earweare/Seed3-Desktop-Dev-Kit/boitier/v2/Comparaison_photo_KiCad.png

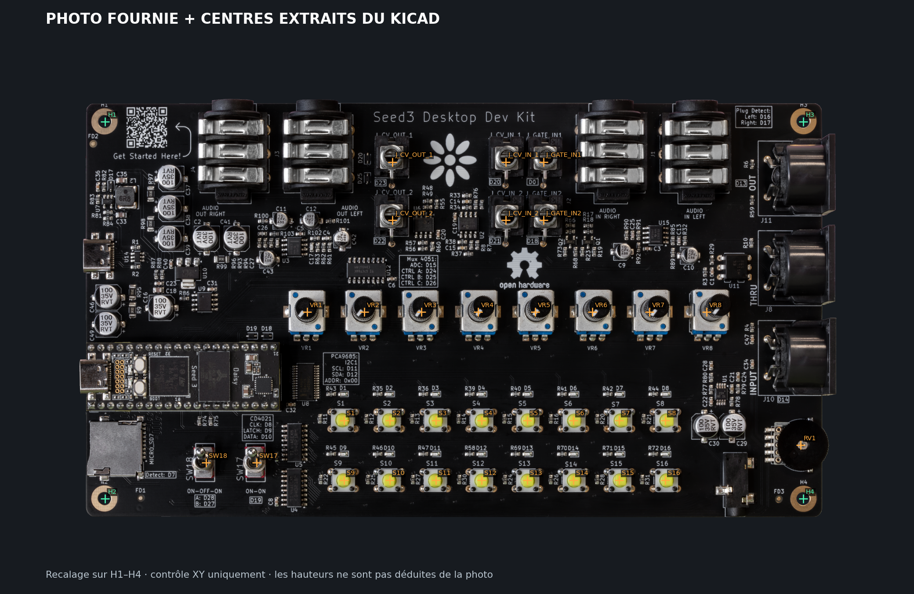
boitier/v2/Comparaison_photo_KiCad.png
