earweare/Seed3-Desktop-Dev-Kit/boitier/v2/Comparaison_photo_oblique.png

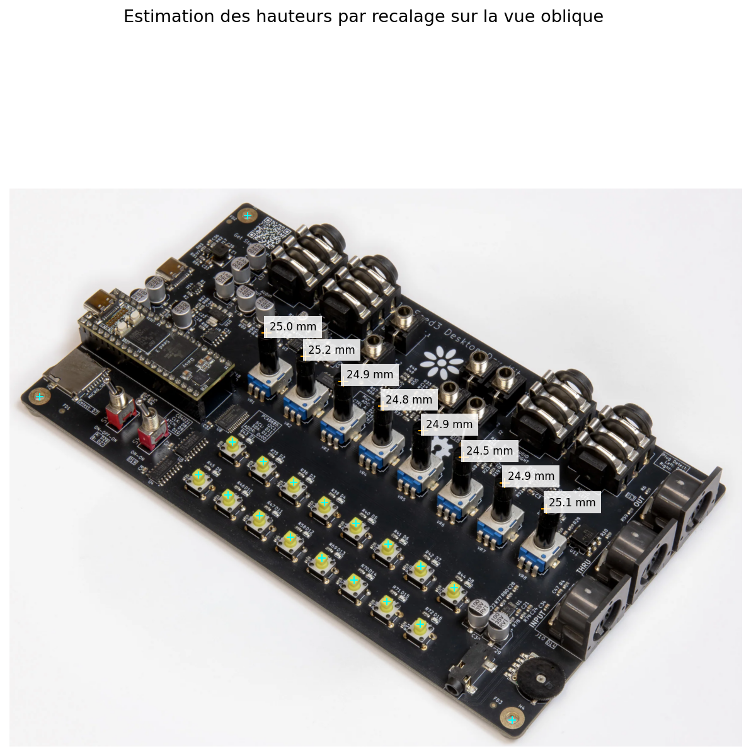
boitier/v2/Comparaison_photo_oblique.png
