earweare/Seed3-Desktop-Dev-Kit/boitier/v2/Vue_3D_board.png

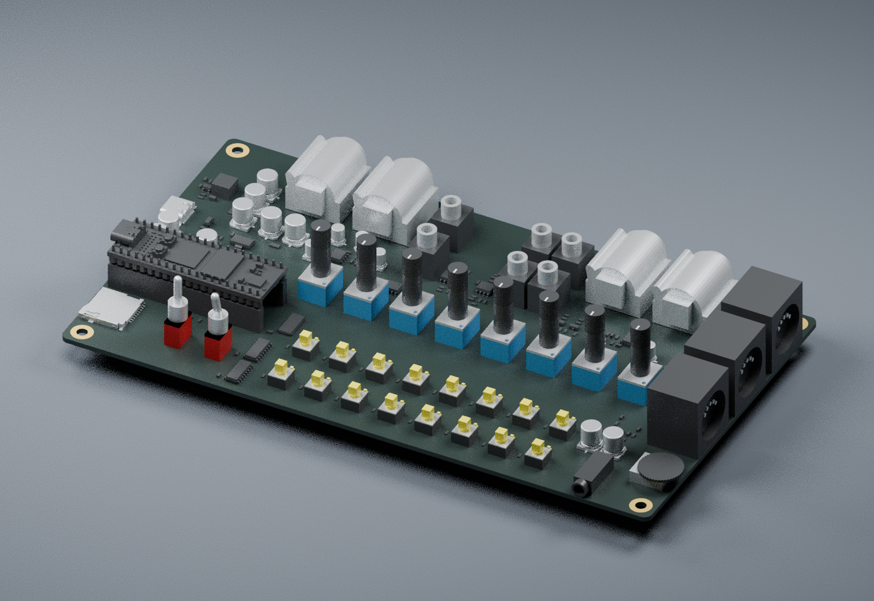
boitier/v2/Vue_3D_board.png
