earweare/Seed3-Desktop-Dev-Kit/boitier/v2/Vue_3D_exploded.png

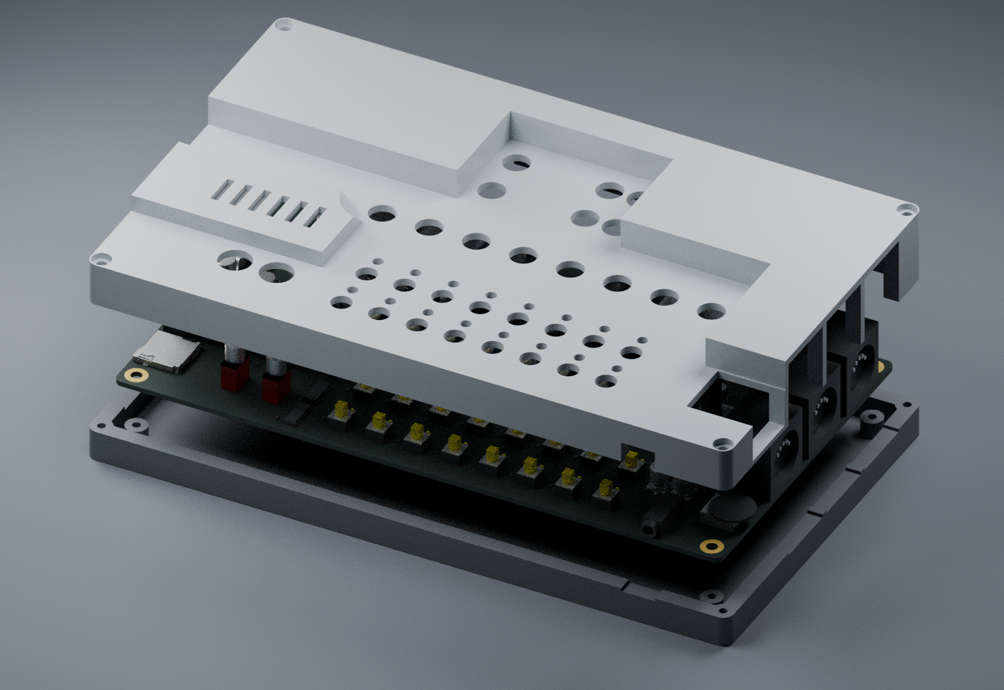
boitier/v2/Vue_3D_exploded.png
