earweare/Seed3-Desktop-Dev-Kit/boitier/v2/Vue_carte_dessus.png

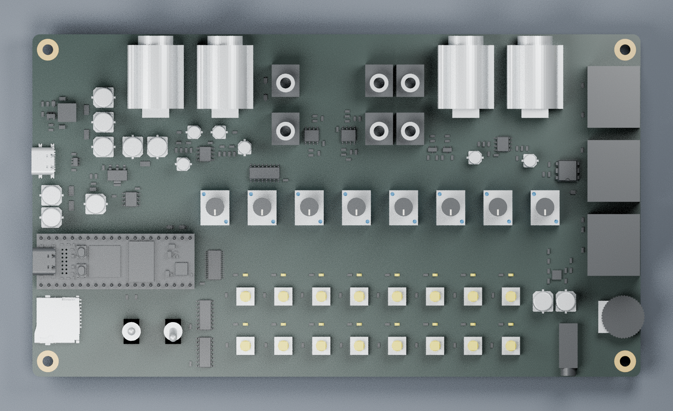
boitier/v2/Vue_carte_dessus.png
