earweare/Seed3-Desktop-Dev-Kit/boitier/v2/Sources/seed3-hardware/pcb/Seed3-DevKit-Desktop/production/ES-Seed3-Devkit-Desktop-Rev4_bom.csv

Value | Reference | Footprint | Qty | AVL_Part_Number
 | J_CV_IN_1,J_CV_IN_2,J_CV_OUT_1,J_CV_OUT_2,J_GATE_IN1,J_GATE_IN2 | Electrosmith-Interface:S_JACK | 6
0R | R84 | Resistor_SMD:R_0603_1608Metric | 1 | 0R R0603
1NF | C14,C15 | Capacitor_SMD:C_0603_1608Metric | 2 | 1NF C0603
1UF | C21 | Capacitor_SMD:C_0603_1608Metric | 1 | 1UF C0603
3R3 | R9,R95,R97,R98,R99 | Resistor_SMD:R_1206_3216Metric | 5 | 3R3
10UF MLCC | C18,C33,C35 | Capacitor_SMD:C_0805_2012Metric | 3 | 10UF MLCC C0805
10R | R6,R10,R29,R59 | Resistor_SMD:R_0603_1608Metric | 4 | 10R R0603
10UF | C9,C10,C11,C12,C42,C43 | Capacitor_SMD:CP_Elec_4x5.8 | 6 | 10UF
100NF | C1,C3,C5,C6,C7,C8,C19,C20,C22,C23,C31,C32,C34,C40,C47 | Capacitor_SMD:C_0603_1608Metric | 15 | 100NF C0603
100R | R23,R55,R60,R73,R102,R103 | Resistor_SMD:R_0603_1608Metric | 6 | 100R R0603
100UF | C2,C16,C29,C30,C37,C38,C39,C41,C46,C49 | Capacitor_SMD:CP_Elec_6.3x7.7 | 10 | 100UF
220R | R4 | Resistor_SMD:R_0603_1608Metric | 1 | 220R R0603
270R | R3 | Resistor_SMD:R_0603_1608Metric | 1 | 270R R0603
470NF | C24,C28 | Capacitor_SMD:C_0603_1608Metric | 2 | 470NF C0603
750R | R62,R93 | Resistor_SMD:R_0603_1608Metric | 2 | 750R R0603
1K | R89,R92 | Resistor_SMD:R_0603_1608Metric | 2 | 1K R0603
2K | R35,R36,R39,R40,R41,R42,R43,R44,R45,R46,R47,R58,R69,R70,R71,R72,R74,R75 | Resistor_SMD:R_0603_1608Metric | 18 | 2K R0603
5K1 | R1,R2 | Resistor_SMD:R_0603_1608Metric | 2 | 5K1 R0603
10K | R11,R12,R13,R14,R15,R16,R19,R20,R21,R22,R24,R25,R26,R27,R28,R30,R31,R61,R68,R83,R85,R86,R87,R88,R91,R96,R100,R101 | Resistor_SMD:R_0603_1608Metric | 28 | 10K R0603
20K | R32,R63,R90,R94 | Resistor_SMD:R_0603_1608Metric | 4 | 20K R0603
22K | R79,R80 | Resistor_SMD:R_0603_1608Metric | 2 | 22K R0603
33K | R5,R7,R34,R38,R77,R78 | Resistor_SMD:R_0603_1608Metric | 6 | 33K R0603
47K | R50,R51,R52,R53,R54 | Resistor_SMD:R_0603_1608Metric | 5 | 47K R0603
62K | R49,R57,R82 | Resistor_SMD:R_0603_1608Metric | 3 | 62K R0603
100K | R8,R17,R33,R37,R66,R76 | Resistor_SMD:R_0603_1608Metric | 6 | 100K R0603
120K | R48,R56 | Resistor_SMD:R_0603_1608Metric | 2 | 120K R0603
1M | R18,R67,R81 | Resistor_SMD:R_0603_1608Metric | 3 | 1M R0603
470PF | C4,C26 | Capacitor_SMD:C_0603_1608Metric | 2 | 470PF C0603
560PF | C36 | Capacitor_SMD:C_0603_1608Metric | 1 | 560PF C0603
1N5817WS | D17,D18,D19,D20,D21,D25 | Diode_SMD:D_SOD-323F | 6 | 1N5817WS
330PF C0G | C13,C25 | Capacitor_SMD:C_0603_1608Metric | 2 | 330PF C0G C0603
470PF C0G | C17,C27 | Capacitor_SMD:C_0603_1608Metric | 2 | 470PF C0G C0603
6.8uH 2.9A | L2 | Inductor_SMD:L_TDK_VLS6045EX_VLS6045AF | 1 | 6.8uH 2.9A
AudioJack3_Switch | J1,J2,J3,J4 | Connector_Audio:Jack_6.35mm_Neutrik_NMJ6HCD2_Horizontal | 4 | AudioJack3_Switch
AudioJack3_Switch_HEADPHONE | J5 | Connector_Audio:Jack_3.5mm_CUI_SJ-3523-SMT_Horizontal | 1 | AudioJack3_Switch_HEADPHONE
CD4051B | U12 | Package_SO:SOIC-16_3.9x9.9mm_P1.27mm | 1 | CD4051B
CD4021BM96 | U4,U5 | Package_SO:SOIC-16_3.9x9.9mm_P1.27mm | 2 | CD4021BM96
DIN_MIDI_5P | J8,J10,J11 | parts-for-kicad:57PC5F | 3 | DIN_MIDI_5P
Electrosmith_Daisy_Seed_Rev4 | A1 | Module:Electrosmith_Daisy_Seed | 1 | Electrosmith_Daisy_Seed_Rev4
H11L1 | U11 | Package_DIP:DIP-6_W7.62mm | 1 | H11L1
LD1117S50TR_SOT223 | U10 | Package_TO_SOT_SMD:SOT-223-3_TabPin2 | 1 | LD1117S50TR_SOT223
LED | D1,D2,D3,D4,D5,D6,D7,D8,D9,D10,D11,D12,D13,D14,D15,D16 | LED_SMD:LED_0603_1608Metric | 16 | LED
LMR62421XMF | U7 | Package_TO_SOT_SMD:SOT-23-5 | 1 | LMR62421XMF
MCP6002-xSN | U2,U6,U9 | Package_SO:SOIC-8_3.9x4.9mm_P1.27mm | 3 | MCP6002-xSN
MMBT3904 | Q1,Q2 | Package_TO_SOT_SMD:SOT-23 | 2 | MMBT3904
OPA1652 | U3,U15 | Package_SO:SOIC-8_3.9x4.9mm_P1.27mm | 2 | OPA1652
P-10K-B-R | VR1,VR2,VR3,VR4,VR5,VR6,VR7,VR8 | parts-for-kicad:9MM_SNAP-IN_POT_SILK | 8 | P-10K-B-R
PCA9685PW | U8 | Package_SO:TSSOP-28_4.4x9.7mm_P0.65mm | 1 | PCA9685PW
PTH Mini Button | S1,S2,S3,S4,S5,S6,S7,S8,S9,S10,S11,S12,S13,S14,S15,S16 | parts-for-kicad:TL1105SPF250Q_SILK | 16 | PTH Mini Button
R_Potentiometer_Dual_Separate | RV1 | shnsly:Rotary Pot RK10J | 1 | R_Potentiometer_Dual_Separate
TF-01A | MICRO_SD7 | TF-01A:TF-01A | 1 | TF-01A
TOGGLE_ON-ON_PIP3 | SW17 | Electrosmith-Interface:TOGGLE_ON-ON | 1 | TOGGLE_ON-ON_PIP3
TOGGLE_ON_OFF_ON_PIP2 | SW18 | Electrosmith-Interface:TOGGLE_ON_OFF_ON | 1 | TOGGLE_ON_OFF_ON_PIP2
TPA6110A2DGN | U1 | Package_SO:HVSSOP-8-1EP_3x3mm_P0.65mm_EP1.57x1.89mm | 1 | TPA6110A2DGN
USB4110GFA | J7 | USB4110GFA:GCT_USB4110GFA | 1 | USB4110GFA
USBLC6-2SC6 | U14 | Package_TO_SOT_SMD:SOT-23-6 | 1 | USBLC6-2SC6
