earweare/Seed3-Desktop-Dev-Kit/boitier/v2/Implantation_KiCad_mm.csv

reference | x_from_left_mm | y_from_front_mm | rotation_deg | footprint
A1 | 2.7950000000000017 | 29.705 | 90.0 | Module:Electrosmith_Daisy_Seed
C1 | 167.4 | 65.6 | -90.0 | Capacitor_SMD:C_0603_1608Metric
C10 | 161.2 | 70.0 | 180.0 | Capacitor_SMD:CP_Elec_4x5.8
C11 | 52.400000000000006 | 79.25 | 180.0 | Capacitor_SMD:CP_Elec_4x5.8
C12 | 60.5 | 79.25 | 0 | Capacitor_SMD:CP_Elec_4x5.8
C13 | 158.6 | 74.0 | 90.0 | Capacitor_SMD:C_0603_1608Metric
C14 | 102.0 | 84.4 | 0 | Capacitor_SMD:C_0603_1608Metric
C15 | 100.80000000000001 | 72.0 | 0 | Capacitor_SMD:C_0603_1608Metric
C16 | 20.5 | 56.0 | 180.0 | Capacitor_SMD:CP_Elec_6.3x7.7
C17 | 60.599999999999994 | 72.2 | -90.0 | Capacitor_SMD:C_0603_1608Metric
C18 | 19.599999999999994 | 60.775000000000006 | 180.0 | Capacitor_SMD:C_0805_2012Metric
C19 | 98.80000000000001 | 80.2 | -90.0 | Capacitor_SMD:C_0603_1608Metric
C2 | 32.5 | 74.5 | 90.0 | Capacitor_SMD:CP_Elec_6.3x7.7
C20 | 94.33000000000001 | 75.6 | -90.0 | Capacitor_SMD:C_0603_1608Metric
C21 | 172.74 | 34.400000000000006 | -90.0 | Capacitor_SMD:C_0603_1608Metric
C22 | 167.2 | 31.0 | 90.0 | Capacitor_SMD:C_0603_1608Metric
C23 | 19.775000000000006 | 62.575 | 180.0 | Capacitor_SMD:C_0603_1608Metric
C24 | 174.4 | 37.599999999999994 | 90.0 | Capacitor_SMD:C_0603_1608Metric
C25 | 146.2 | 75.4 | 90.0 | Capacitor_SMD:C_0603_1608Metric
C26 | 47.400000000000006 | 75.8 | 0 | Capacitor_SMD:C_0603_1608Metric
C27 | 51.400000000000006 | 73.4 | -90.0 | Capacitor_SMD:C_0603_1608Metric
C28 | 167.2 | 40.599999999999994 | 90.0 | Capacitor_SMD:C_0603_1608Metric
C29 | 172.8 | 24.400000000000006 | -90.0 | Capacitor_SMD:CP_Elec_6.3x7.7
C3 | 150.2 | 71.8 | 180.0 | Capacitor_SMD:C_0603_1608Metric
C30 | 165.4 | 24.400000000000006 | -90.0 | Capacitor_SMD:CP_Elec_6.3x7.7
C31 | 34.0 | 61.004999999999995 | 180.0 | Capacitor_SMD:C_0603_1608Metric
C32 | 55.025000000000006 | 30.200000000000003 | 0 | Capacitor_SMD:C_0603_1608Metric
C33 | 9.600000000000001 | 80.9 | 0 | Capacitor_SMD:C_0805_2012Metric
C34 | 178.2 | 41.0 | -90.0 | Capacitor_SMD:C_0603_1608Metric
C35 | 9.700000000000003 | 90.1 | 0 | Capacitor_SMD:C_0805_2012Metric
C36 | 3.299999999999997 | 88.4 | 90.0 | Capacitor_SMD:C_0603_1608Metric
C37 | 23.0 | 90.5 | 0 | Capacitor_SMD:CP_Elec_6.3x7.7
C38 | 23.0 | 82.5 | 0 | Capacitor_SMD:CP_Elec_6.3x7.7
C39 | 23.0 | 74.5 | 0 | Capacitor_SMD:CP_Elec_6.3x7.7
C4 | 64.6 | 74.6 | 180.0 | Capacitor_SMD:C_0603_1608Metric
C40 | 23.0 | 67.75 | -90.0 | Capacitor_SMD:C_0603_1608Metric
C41 | 40.5 | 74.5 | 90.0 | Capacitor_SMD:CP_Elec_6.3x7.7
C42 | 68.75 | 74.25 | -90.0 | Capacitor_SMD:CP_Elec_4x5.8
C43 | 48.900000000000006 | 68.9 | 180.0 | Capacitor_SMD:CP_Elec_4x5.8
C46 | 6.200000000000003 | 58.8 | 180.0 | Capacitor_SMD:CP_Elec_6.3x7.7
C47 | 178.2 | 47.599999999999994 | 90.0 | Capacitor_SMD:C_0603_1608Metric
C49 | 6.200000000000003 | 51.599999999999994 | 180.0 | Capacitor_SMD:CP_Elec_6.3x7.7
C5 | 57.599999999999994 | 75.8 | 0 | Capacitor_SMD:C_0603_1608Metric
C6 | 82.02625 | 63.712500000000006 | 0 | Capacitor_SMD:C_0603_1608Metric
C7 | 51.2 | 16.224999999999994 | 90.0 | Capacitor_SMD:C_0603_1608Metric
C8 | 51.2 | 4.199999999999989 | 90.0 | Capacitor_SMD:C_0603_1608Metric
C9 | 143.4 | 71.0 | 180.0 | Capacitor_SMD:CP_Elec_4x5.8
D1 | 69.0 | 33.0 | 180.0 | LED_SMD:LED_0603_1608Metric
D10 | 81.28571400000001 | 17.0 | 180.0 | LED_SMD:LED_0603_1608Metric
D11 | 93.571429 | 17.0 | 180.0 | LED_SMD:LED_0603_1608Metric
D12 | 105.85714300000001 | 17.0 | 180.0 | LED_SMD:LED_0603_1608Metric
D13 | 118.14285699999999 | 17.0 | 180.0 | LED_SMD:LED_0603_1608Metric
D14 | 130.428571 | 17.0 | 180.0 | LED_SMD:LED_0603_1608Metric
D15 | 142.714286 | 17.0 | 180.0 | LED_SMD:LED_0603_1608Metric
D16 | 155.0 | 17.0 | 180.0 | LED_SMD:LED_0603_1608Metric
D17 | 6.799999999999997 | 88.5 | -90.0 | Diode_SMD:D_SOD-323F
D18 | 48.5 | 48.5 | 180.0 | Diode_SMD:D_SOD-323F
D19 | 44.5 | 48.5 | 180.0 | Diode_SMD:D_SOD-323F
D2 | 81.28571400000001 | 33.0 | 180.0 | LED_SMD:LED_0603_1608Metric
D20 | 75.5 | 96.0 | 90.0 | Diode_SMD:D_SOD-323F
D21 | 175.13 | 59.775000000000006 | 180.0 | Diode_SMD:D_SOD-323F
D25 | 75.5 | 90.5 | -90.0 | Diode_SMD:D_SOD-323F
D3 | 93.571429 | 33.0 | 180.0 | LED_SMD:LED_0603_1608Metric
D4 | 105.85714300000001 | 33.0 | 180.0 | LED_SMD:LED_0603_1608Metric
D5 | 118.14285699999999 | 33.0 | 180.0 | LED_SMD:LED_0603_1608Metric
D6 | 130.428571 | 33.0 | 180.0 | LED_SMD:LED_0603_1608Metric
D7 | 142.714286 | 33.0 | 180.0 | LED_SMD:LED_0603_1608Metric
D8 | 155.0 | 33.0 | 180.0 | LED_SMD:LED_0603_1608Metric
D9 | 69.0 | 17.0 | 180.0 | LED_SMD:LED_0603_1608Metric
FD1 | 14.769999999999996 | 5.139999999999986 | 0 | Fiducial:Fiducial_1mm_Mask2mm
FD2 | 2.001100000000001 | 99.9964 | 0 | Fiducial:Fiducial_1mm_Mask2mm
FD3 | 185.4 | 5.0 | 0 | Fiducial:Fiducial_1mm_Mask2mm
H1 | 5.0 | 106.0 | 0 | MountingHole:MountingHole_3.5mm_Pad
H2 | 5.0 | 5.0 | 0 | MountingHole:MountingHole_3.5mm_Pad
H3 | 192.0 | 106.0 | 0 | MountingHole:MountingHole_3.5mm_Pad
H4 | 192.0 | 5.0 | 0 | MountingHole:MountingHole_3.5mm_Pad
J1 | 154.685 | 90.765 | 90.0 | Connector_Audio:Jack_6.35mm_Neutrik_NMJ6HCD2_Horizontal
J10 | 184.8 | 42.7 | 90.0 | PartsFromEagle:57PC5F
J11 | 184.8 | 90.7 | 90.0 | PartsFromEagle:57PC5F
J2 | 132.285 | 90.765 | 90.0 | Connector_Audio:Jack_6.35mm_Neutrik_NMJ6HCD2_Horizontal
J3 | 54.285 | 90.765 | 90.0 | Connector_Audio:Jack_6.35mm_Neutrik_NMJ6HCD2_Horizontal
J4 | 31.799999999999997 | 90.8 | 90.0 | Connector_Audio:Jack_6.35mm_Neutrik_NMJ6HCD2_Horizontal
J5 | 173.6 | 8.800000000000011 | 180.0 | Connector_Audio:Jack_3.5mm_CUI_SJ-3523-SMT_Horizontal
J7 | 6.0 | 69.91 | -90.0 | USB4110GFA:GCT_USB4110GFA
J8 | 184.8 | 66.7 | 90.0 | PartsFromEagle:57PC5F
J_CV_IN_1 | 112.30000000000001 | 95.2 | 0 | PartsFromEagle:EURO_JACK_3.5MM
J_CV_IN_2 | 112.30000000000001 | 79.6 | 0 | PartsFromEagle:EURO_JACK_3.5MM
J_CV_OUT_1 | 82.0 | 95.2 | 0 | PartsFromEagle:EURO_JACK_3.5MM
J_CV_OUT_2 | 82.0 | 79.6 | 0 | PartsFromEagle:EURO_JACK_3.5MM
J_GATE_IN1 | 122.4 | 95.2 | 0 | PartsFromEagle:EURO_JACK_3.5MM
J_GATE_IN2 | 122.4 | 79.6 | 0 | PartsFromEagle:EURO_JACK_3.5MM
L2 | 11.200000000000003 | 85.6 | 90.0 | Inductor_SMD:L_TDK_VLS6045EX_VLS6045AF
LOGO1 | 117.35 | 66.5 | 0 | Symbol:OSHW-Logo2_14.6x12mm_SilkScreen
MICRO_SD7 | 8.274999999999999 | 18.30000000000001 | -90.0 | TF-01A:TF-01A
Q1 | 134.3875 | 73.54 | -90.0 | Package_TO_SOT_SMD:SOT-23
Q2 | 129.6 | 73.6 | -90.0 | Package_TO_SOT_SMD:SOT-23
QR1 | 16.400000000000006 | 104.3 | 0 | shnsly:qr-seed3-desktop-redirect-medium
R1 | 13.399999999999999 | 72.2 | 0 | Resistor_SMD:R_0603_1608Metric
R10 | 178.0 | 73.4 | 90.0 | Resistor_SMD:R_0603_1608Metric
R100 | 47.5 | 79.2 | 180.0 | Resistor_SMD:R_0603_1608Metric
R101 | 65.6 | 79.2 | 0 | Resistor_SMD:R_0603_1608Metric
R102 | 61.442499999999995 | 74.6 | 0 | Resistor_SMD:R_0603_1608Metric
R103 | 50.575 | 75.8 | 0 | Resistor_SMD:R_0603_1608Metric
R11 | 62.8 | 26.400000000000006 | -90.0 | Resistor_SMD:R_0603_1608Metric
R12 | 75.2 | 26.400000000000006 | -90.0 | Resistor_SMD:R_0603_1608Metric
R13 | 87.4 | 26.400000000000006 | -90.0 | Resistor_SMD:R_0603_1608Metric
R14 | 99.80000000000001 | 26.400000000000006 | -90.0 | Resistor_SMD:R_0603_1608Metric
R15 | 112.0 | 26.400000000000006 | -90.0 | Resistor_SMD:R_0603_1608Metric
R16 | 124.4 | 26.400000000000006 | -90.0 | Resistor_SMD:R_0603_1608Metric
R17 | 134.3875 | 77.985 | 0 | Resistor_SMD:R_0603_1608Metric
R18 | 134.3875 | 76.3975 | 0 | Resistor_SMD:R_0603_1608Metric
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
R80 | 167.2 | 37.425 | -90.0 | Resistor_SMD:R_0603_1608Metric
R81 | 6.0 | 81.6 | 0 | Resistor_SMD:R_0603_1608Metric
R82 | 4.899999999999999 | 88.4 | -90.0 | Resistor_SMD:R_0603_1608Metric
R83 | 3.299999999999997 | 85.1 | -90.0 | Resistor_SMD:R_0603_1608Metric
R84 | 6.0 | 80.0 | 180.0 | Resistor_SMD:R_0603_1608Metric
R85 | 157.0 | 74.0 | -90.0 | Resistor_SMD:R_0603_1608Metric
R86 | 26.5 | 58.5 | 180.0 | Resistor_SMD:R_0603_1608Metric
R87 | 19.0 | 64.975 | -90.0 | Resistor_SMD:R_0603_1608Metric
R88 | 20.599999999999994 | 64.975 | 90.0 | Resistor_SMD:R_0603_1608Metric
R89 | 157.0 | 70.8 | -90.0 | Resistor_SMD:R_0603_1608Metric
R9 | 12.600000000000001 | 55.400000000000006 | -90.0 | Resistor_SMD:R_1206_3216Metric
R90 | 144.6 | 75.4 | -90.0 | Resistor_SMD:R_0603_1608Metric
R91 | 147.8 | 75.4 | -90.0 | Resistor_SMD:R_0603_1608Metric
R92 | 147.8 | 72.2 | -90.0 | Resistor_SMD:R_0603_1608Metric
R93 | 48.2 | 73.4 | 90.0 | Resistor_SMD:R_0603_1608Metric
R94 | 49.8 | 73.4 | -90.0 | Resistor_SMD:R_0603_1608Metric
R95 | 12.600000000000001 | 60.2 | -90.0 | Resistor_SMD:R_1206_3216Metric
R96 | 46.599999999999994 | 73.4 | -90.0 | Resistor_SMD:R_0603_1608Metric
R97 | 17.5 | 86.5 | -90.0 | Resistor_SMD:R_1206_3216Metric
R98 | 17.5 | 78.5 | -90.0 | Resistor_SMD:R_1206_3216Metric
R99 | 36.5 | 69.0 | 0 | Resistor_SMD:R_1206_3216Metric
RV1 | 191.325 | 19.400000000000006 | -90.0 | shnsly:Rotary Pot RK10J
S1 | 69.0 | 26.0 | 0 | PartsFromEagle:TL1105SPF250Q_SILK
S10 | 81.28571400000001 | 10.0 | 0 | PartsFromEagle:TL1105SPF250Q_SILK
S11 | 93.571429 | 10.0 | 0 | PartsFromEagle:TL1105SPF250Q_SILK
S12 | 105.85714300000001 | 10.0 | 0 | PartsFromEagle:TL1105SPF250Q_SILK
S13 | 118.14285699999999 | 10.0 | 0 | PartsFromEagle:TL1105SPF250Q_SILK
S14 | 130.428571 | 10.0 | 0 | PartsFromEagle:TL1105SPF250Q_SILK
S15 | 142.714286 | 10.0 | 0 | PartsFromEagle:TL1105SPF250Q_SILK
S16 | 155.0 | 10.0 | 0 | PartsFromEagle:TL1105SPF250Q_SILK
S2 | 81.28571400000001 | 26.0 | 0 | PartsFromEagle:TL1105SPF250Q_SILK
S3 | 93.571429 | 26.0 | 0 | PartsFromEagle:TL1105SPF250Q_SILK
S4 | 105.85714300000001 | 26.0 | 0 | PartsFromEagle:TL1105SPF250Q_SILK
S5 | 118.14285699999999 | 26.0 | 0 | PartsFromEagle:TL1105SPF250Q_SILK
S6 | 130.428571 | 26.0 | 0 | PartsFromEagle:TL1105SPF250Q_SILK
S7 | 142.714286 | 26.0 | 0 | PartsFromEagle:TL1105SPF250Q_SILK
S8 | 155.0 | 26.0 | 0 | PartsFromEagle:TL1105SPF250Q_SILK
S9 | 69.0 | 10.0 | 0 | PartsFromEagle:TL1105SPF250Q_SILK
SW17 | 45.567499999999995 | 14.664999999999992 | 90.0 | PartsFromEagle:TOGGLE_ON_ON_2
SW18 | 32.073750000000004 | 14.664999999999992 | 90.0 | PartsFromEagle:TOGGLE_ON_OFF_ON
U1 | 169.87 | 32.989999999999995 | -90.0 | Package_SO:HVSSOP-8-1EP_3x3mm_P0.65mm_EP1.57x1.89mm
U10 | 27.5 | 65.25 | -90.0 | Package_TO_SOT_SMD:SOT-223-3_TabPin2
U11 | 177.205 | 64.26 | 180.0 | Package_DIP:DIP-6_W7.62mm
U12 | 75.2 | 66.0 | -90.0 | Package_SO:SOIC-16_3.9x9.9mm_P1.27mm
U14 | 13.950099999999999 | 69.6 | 0 | Package_TO_SOT_SMD:SOT-23-6
U15 | 152.4 | 75.4 | 180.0 | Package_SO:SOIC-8_3.9x4.9mm_P1.27mm
U2 | 102.4 | 78.2 | 90.0 | Package_SO:SOIC-8_3.9x4.9mm_P1.27mm
U3 | 56.0 | 72.2 | 0 | Package_SO:SOIC-8_3.9x4.9mm_P1.27mm
U4 | 55.925 | 7.905000000000001 | 180.0 | Package_SO:SOIC-16_3.9x9.9mm_P1.27mm
U5 | 56.0 | 20.0 | 180.0 | Package_SO:SOIC-16_3.9x9.9mm_P1.27mm
U6 | 90.435 | 78.125 | -90.0 | Package_SO:SOIC-8_3.9x4.9mm_P1.27mm
U7 | 6.0 | 84.5 | -90.0 | Package_TO_SOT_SMD:SOT-23-5
U8 | 59.0 | 36.2 | 180.0 | Package_SO:TSSOP-28_4.4x9.7mm_P0.65mm
U9 | 31.974999999999994 | 57.5 | 0 | Package_SO:SOIC-8_3.9x4.9mm_P1.27mm
VR1 | 59.12350000000001 | 55.0 | 0 | PartsFromEagle:9MM_SNAP-IN_POT_SILK
VR2 | 74.4025 | 55.0 | 0 | PartsFromEagle:9MM_SNAP-IN_POT_SILK
VR3 | 89.6815 | 55.0 | 0 | PartsFromEagle:9MM_SNAP-IN_POT_SILK
VR4 | 104.9605 | 55.0 | 0 | PartsFromEagle:9MM_SNAP-IN_POT_SILK
VR5 | 120.23949999999999 | 55.0 | 0 | PartsFromEagle:9MM_SNAP-IN_POT_SILK
VR6 | 135.5185 | 55.0 | 0 | PartsFromEagle:9MM_SNAP-IN_POT_SILK
VR7 | 150.7975 | 55.0 | 0 | PartsFromEagle:9MM_SNAP-IN_POT_SILK
VR8 | 166.0765 | 55.0 | 0 | PartsFromEagle:9MM_SNAP-IN_POT_SILK
