earweare/Seed3-Desktop-Dev-Kit/boitier/v2/Boitier_Seed3.step

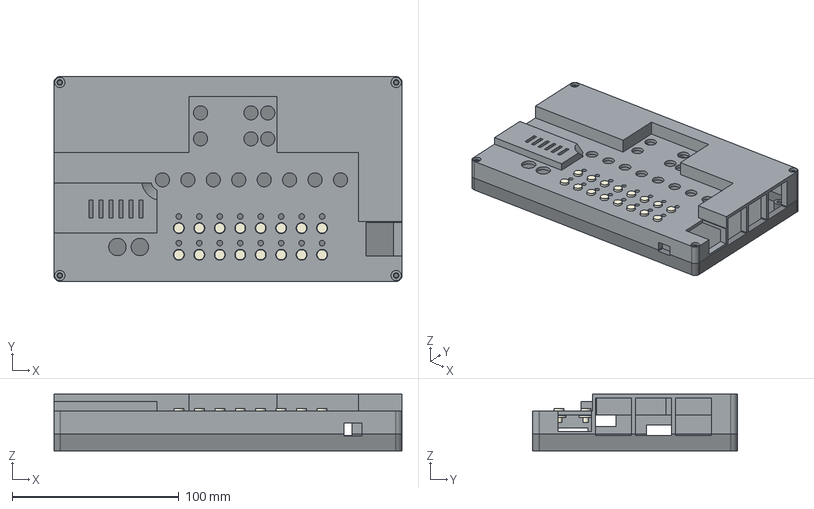
[picture p8: CAD file, 2026-11-10]
boitier/v2/Boitier_Seed3.step
209.0 x 123.0 x 34.0 mm
Socle
Capot
Poussoir_01
Poussoir_02
Poussoir_03
Poussoir_04
Poussoir_05
Poussoir_06
Poussoir_07
Poussoir_08
Poussoir_09
Poussoir_10
Poussoir_11
Poussoir_12
Poussoir_13
Poussoir_14
Poussoir_15
Poussoir_16
