earweare/Seed3-Desktop-Dev-Kit/boitier/v2/Sources/enclosure/models/NMJ6HCD2.stp

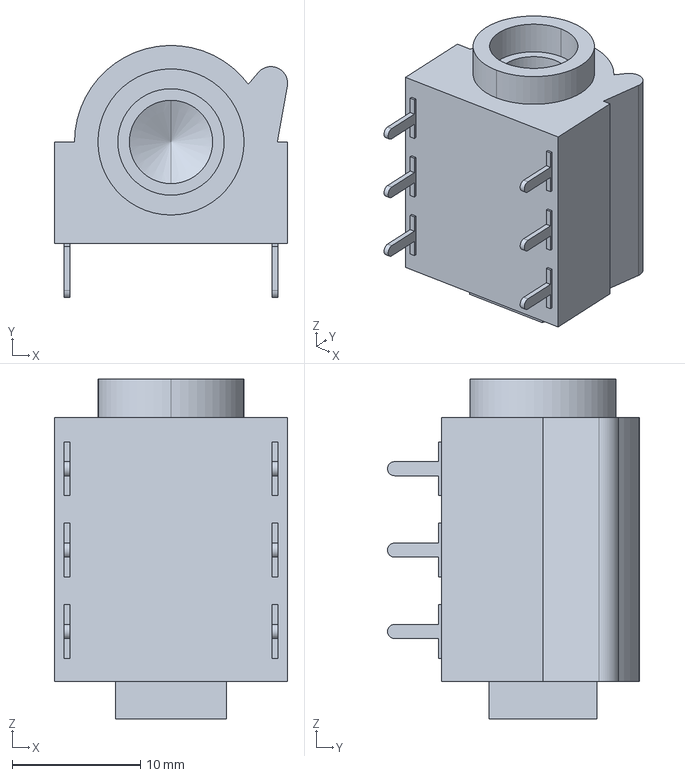
[picture p9: CAD file, 2026-11-10]
boitier/v2/Sources/enclosure/models/NMJ6HCD2.stp
18.2 x 19.7 x 26.5 mm
