earweare/Seed3-Desktop-Dev-Kit/boitier/v2/Socle.stl

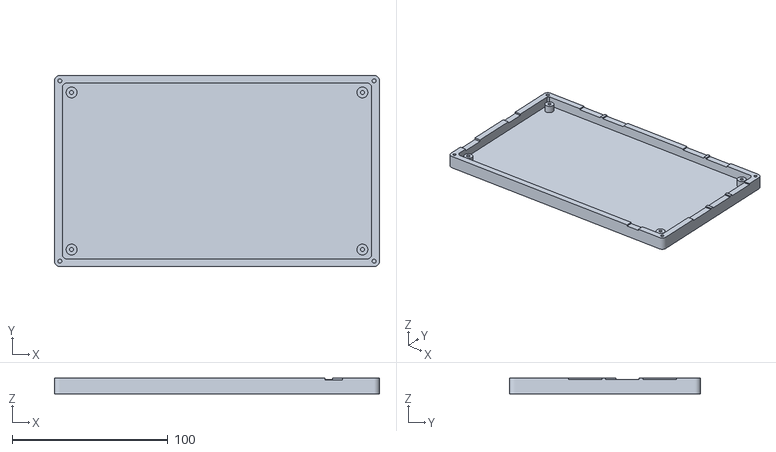
[picture p11: CAD file, 2026-11-10]
boitier/v2/Socle.stl
209.0 x 123.0 x 10.0
