earweare/Seed3-Desktop-Dev-Kit/boitier/v2/Capot.stl

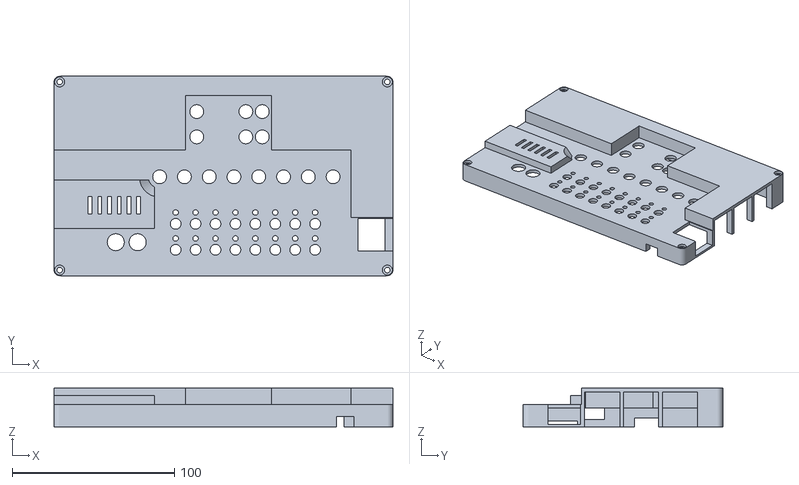
[picture p12: CAD file, 2026-11-10]
boitier/v2/Capot.stl
209.0 x 123.0 x 24.0
