earweare/Seed3-Desktop-Dev-Kit/boitier/v2/Poussoir_x16.stl

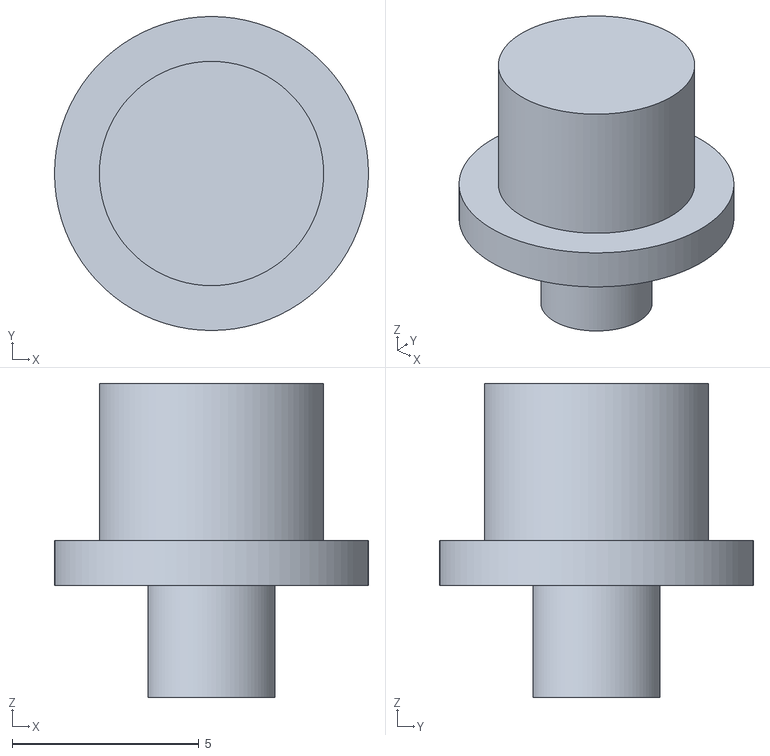
[picture p13: CAD file, 2026-11-10]
boitier/v2/Poussoir_x16.stl
8.40 x 8.40 x 8.40
